cold-inferno/c5-ula-replacement/hardware/eagle-xml/ULA_Replacement.brd

## EAGLE design hardware/eagle-xml/ULA_Replacement.brd (2026-11-09)

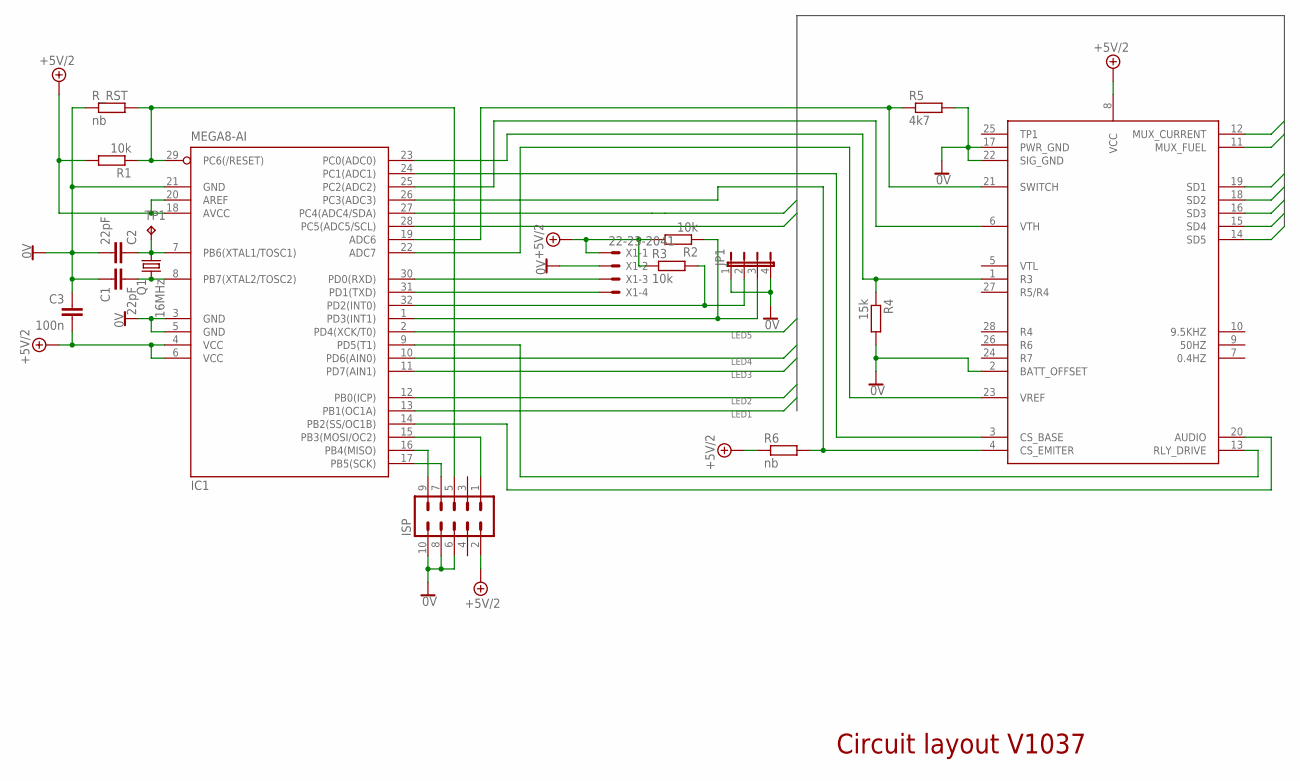
[picture p5: schematic ULA_Replacement.sch]

Parts:
C1, C2: 22pF; C0805
C3: 100n; C0805
IC1: MEGA8-AI; TQFP32-08
ISP: ML10
JP1: JP4E; JP4
Q1: 16MHz; HC49/S
R1, R2, R3: 10k; M0805
R4: 15k; M0805
R5: 4k7; M0805
R6: nb; M0805
R_RST: nb; 0204V
TP1: TPB1,27; B1,27
U$1: C5_ULA
X1: 22-23-2041

Connections:
+5V/2: C3.2, IC1.4 (VCC), IC1.6 (VCC), IC1.18 (AVCC), IC1.20 (AREF), ISP.2, R1.2, R2.2, R3.1, R6.1, U$1.8 (VCC), X1.1
/RESET: IC1.29 (PC6(/RESET)), ISP.5, R1.1, R_RST.2
AUDIO: IC1.14 (PB2(SS/OC1B)), U$1.20 (AUDIO)
CS_BASE: IC1.24 (PC1(ADC1)), U$1.3 (CS_BASE)
CS_EMITER: IC1.26 (PC3(ADC3)), R6.2, U$1.4 (CS_EMITER)
GND: C1.1, C2.2, C3.1, IC1.3 (GND), IC1.5 (GND), IC1.21 (GND), ISP.6, ISP.8, ISP.10, JP1.1, JP1.4, R4.2, R5.2, R_RST.1, U$1.2 (BATT_OFFSET), U$1.17 (PWR_GND), U$1.22 (SIG_GND), X1.2
INT0: IC1.32 (PD2(INT0)), JP1.2, R3.2
INT1: IC1.1 (PD3(INT1)), JP1.3, R2.1
LED1: IC1.13 (PB1(OC1A)), U$1.19 (SD1)
LED2: IC1.12 (PB0(ICP)), U$1.18 (SD2)
LED3: IC1.11 (PD7(AIN1)), U$1.16 (SD3)
LED4: IC1.10 (PD6(AIN0)), U$1.15 (SD4)
LED5: IC1.2 (PD4(XCK/T0)), U$1.14 (SD5)
MISO: IC1.16 (PB4(MISO)), ISP.9
MOSI: IC1.15 (PB3(MOSI/OC2)), ISP.1
MX_CURRENT: IC1.28 (PC5(ADC5/SCL)), U$1.12 (MUX_CURRENT)
MX_FUEL: IC1.27 (PC4(ADC4/SDA)), U$1.11 (MUX_FUEL)
R3: IC1.23 (PC0(ADC0)), R4.1, U$1.1 (R3)
RLY_DRIVE: IC1.9 (PD5(T1)), U$1.13 (RLY_DRIVE)
RXD: IC1.30 (PD0(RXD)), X1.3
SCK: IC1.17 (PB5(SCK)), ISP.7
SWITCH: IC1.19 (ADC6), R5.1, U$1.21 (SWITCH)
TXD: IC1.31 (PD1(TXD)), X1.4
VREF: IC1.22 (ADC7), U$1.23 (VREF)
VTH: IC1.25 (PC2(ADC2)), U$1.6 (VTH)
XTAL1: C2.1, IC1.7 (PB6(XTAL1/TOSC1)), Q1.1, TP1.TP
XTAL2: C1.2, IC1.8 (PB7(XTAL2/TOSC2)), Q1.2

Notes on the sheet:
Circuit layout V1037

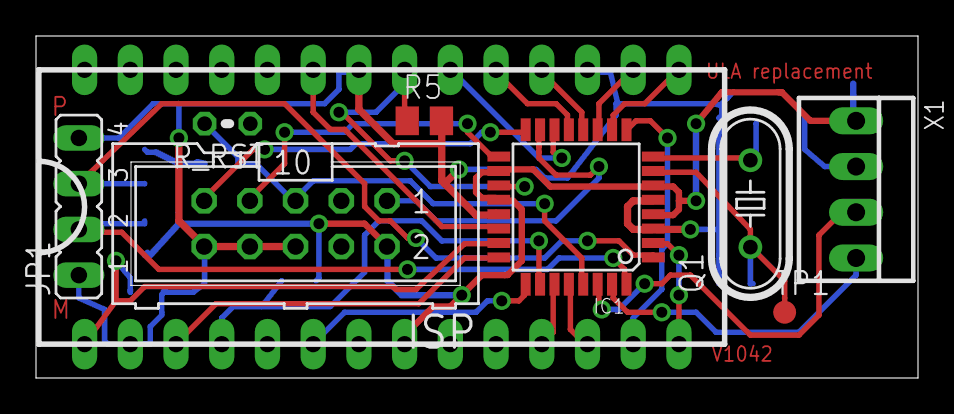
[picture p6: board ULA_Replacement.brd from above]

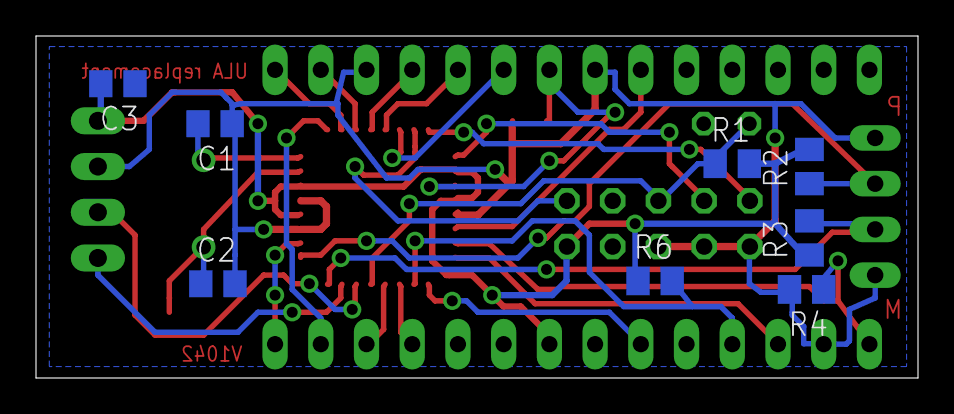
[picture p7: board ULA_Replacement.brd from below]

Board: 2 copper layers, 49.0 x 19.0 mm, 17 parts (8 on the bottom side), 27 nets.
