cold-inferno/c5-ula-replacement/global.h

#define _GLOBAL_H
#define EXTERN extern
#define WHEEL_SIZE                 1280U
#define SPEEDLIMIT_MAX              250U
#define SPEEDLIMIT_MIN               30U
#define DEFAULT_MAGNET_NUMBER_TACHO   1U
#define DEFAULT_MAGNET_NUMBER_PEDAL   1U
#if !defined(BATTERY_LIFEPO4) && !defined(BATTERY_LEAD_ACID)
#define BATTERY_LIFEPO4
#endif
#define VOLT_ADC(mV)    ((UINT16)(((UINT32)(mV) * 48UL) / 1000UL - 32UL))
#if defined(BATTERY_LIFEPO4)
  #define BATTERY_NAME          "LiFePO4"
  #define VOLT_LED1             VOLT_ADC(12500U)
  #define VOLT_LED2             VOLT_ADC(12900U)
  #define VOLT_LED3             VOLT_ADC(13050U)
  #define VOLT_LED4             VOLT_ADC(13150U)
  #define VOLT_LED5             VOLT_ADC(13300U)
  #define VOLT_WARN_ON          VOLT_ADC(12800U)
  #define VOLT_WARN_OFF         VOLT_ADC(12900U)
  #define VOLT_ERR_ON           VOLT_ADC(12000U)
  #define VOLT_ERR_OFF          VOLT_ADC(12300U)
  #define VOLT_ERR_LOADED       VOLT_ADC(11000U)
  #define VOLT_REST_SETTLE      6U
#else
  #define BATTERY_NAME          "lead-acid"
  #define VOLT_LED1             VOLT_ADC(10000U)
  #define VOLT_LED2             VOLT_ADC(10500U)
  #define VOLT_LED3             VOLT_ADC(11000U)
  #define VOLT_LED4             VOLT_ADC(11500U)
  #define VOLT_LED5             VOLT_ADC(12000U)
  #define VOLT_REST_SETTLE      6U
#endif
#define RXD_PORT            PORTD
#define RXD_DDR             DDRD
#define RXD_BIT             PD0
#define TXD_PORT            PORTD
#define TXD_DDR             DDRD
#define TXD_BIT             PD1
#define LED1_PORT           PORTB
#define LED1_DDR            DDRB
#define LED1_BIT            PB1
#define LED2_PORT           PORTB
#define LED2_DDR            DDRB
#define LED2_BIT            PB0
#define LED3_PORT           PORTD
#define LED3_DDR            DDRD
#define LED3_BIT            PD7
#define LED4_PORT           PORTD
#define LED4_DDR            DDRD
#define LED4_BIT            PD6
#define LED5_PORT           PORTD
#define LED5_DDR            DDRD
#define LED5_BIT            PD4
#define MUX_VOLT_PORT       PORTC
#define MUX_VOLT_DDR        DDRC
#define MUX_VOLT_BIT        PC4
#define MUX_CURR_PORT       PORTC
#define MUX_CURR_DDR        DDRC
#define MUX_CURR_BIT        PC5
#define SPEAKER_PORT        PORTB
#define SPEAKER_DDR         DDRB
#define SPEAKER_BIT         PB2
#define RELAY_PORT          PORTD
#define RELAY_DDR           DDRD
#define RELAY_BIT           PD5
#define FAN_PORT            PORTC
#define FAN_DDR             DDRC
#define FAN_BIT             PC3
#define INT0_PORT           PORTD
#define INT0_DDR            DDRD
#define INT0_BIT            PD2
#define INT1_PORT           PORTD
#define INT1_DDR            DDRD
#define INT1_BIT            PD3
#define VREF_PORT           PORTC
#define VREF_DDR            DDRC
#define VREF_BIT            7
#define CSBASE_PORT         PORTC
#define CSBASE_DDR          DDRC
#define CSBASE_BIT          PC1
#define R3_PORT             PORTC
#define R3_DDR              DDRC
#define R3_BIT              PC0
#define VTH_PORT            PORTC
#define VTH_DDR             DDRC
#define VTH_BIT             PC2
#define SWITCH_PORT         PORTC
#define SWITCH_DDR          DDRC
#define SWITCH_BIT          6
#define ADC_SWITCH          ADC6
#define ADC_TEMPERATURE     ADC2
#define ADC_VOLTAGE         ADC0
#define ADC_VREF            ADC7
#define ADC_CURRENT         ADC1
#define SWITCH_ON_ADC       300U
#define MAX_CURRENT         523U
#define VALUE_TEMP_FAN        45U // 45°C
#define VALUE_TEMP_WARN       70U // 70°C
#define VALUE_TEMP_ERROR      80U // 80°C
#define ONE_MINUTE_MS       ((UINT32)60000UL)
#define FW_VERSION          1203U  // 2026: V1200 LiFePO4 + pedelec, V1201 speed bar, V1202 ride log, V1203 fault codes + resting voltage fix
#define APPLICATION_CRC     0xFFFFFFFFUL // patched after build by tools/fwcrc.py
#define CRC32POLY           0xEDB88320UL
#define STATIC              static
#define LOCAL_STATIC        static
#define CONST               const
#define VOLATILE            volatile
#define SECTION_EEMEM       __attribute__ ((section (".eeprom")))
#define SECTION_VERSION     __attribute__ ((section (".app_ver")))
#define SECTION_CRC         __attribute__ ((section (".app_crc")))
#define HIGH_BYTE(x) ((UINT8) (x >> 8U))
#define LOW_BYTE(x)  ((UINT8)  x)
#define LED1_ON()       LED1_PORT &= ~(1U << LED1_BIT);
#define LED1_OFF()      LED1_PORT |=  (1U << LED1_BIT);
#define LED2_ON()       LED2_PORT &= ~(1U << LED2_BIT);
#define LED2_OFF()      LED2_PORT |=  (1U << LED2_BIT);
#define LED3_ON()       LED3_PORT &= ~(1U << LED3_BIT);
#define LED3_OFF()      LED3_PORT |=  (1U << LED3_BIT);
#define LED4_ON()       LED4_PORT &= ~(1U << LED4_BIT);
#define LED4_OFF()      LED4_PORT |=  (1U << LED4_BIT);
#define LED5_ON()       LED5_PORT &= ~(1U << LED5_BIT);
#define LED5_OFF()      LED5_PORT |=  (1U << LED5_BIT);
#define ALL_LEDS_ON()   {LED1_ON(); LED2_ON(); LED3_ON(); \
                         LED4_ON(); LED5_ON();}
#define ALL_LEDS_OFF()  {LED1_OFF(); LED2_OFF(); LED3_OFF(); \
                         LED4_OFF();LED5_OFF();}
#define MUX_CURR()      { MUX_CURR_PORT |=  (1U << MUX_CURR_BIT); \
                          MUX_VOLT_PORT &= ~(1U << MUX_VOLT_BIT); }
#define MUX_VOLT()      { MUX_VOLT_PORT |=  (1U << MUX_VOLT_BIT); \
                          MUX_CURR_PORT &= ~(1U << MUX_CURR_BIT); }
#ifndef BOOTLOADER
EXTERN const UINT32           g_u32ApplicationCRC;
EXTERN const UINT16           g_u16ApplicationVersion;
#endif
EXTERN const S_MEM_STRUCTRUE  sMemoryEEPROM;
#undef EXTERN
