cold-inferno/c5-ula-replacement/(commit log)

2026-11-06 Import cypax ULA replacement firmware V1172 (CRLF normalised)
    [adc.c, adc.h, bootload.c, bootload.h, current.c, current.h, fan.c, fan.h]
2026-11-06 Firmware V1200: LiFePO4 profile, pedelec fixes, browser configurator
    Firmware (builds with avr-gcc 14, 5488 of 7162 bytes):
    - Port to modern avr-libc (ISR vector names, chip detection, avr-size)
    - Replace printf/fdevopen with small print functions (~1.4 KB freed)
    - Speed uses the configured wheel size (was fixed 1280 mm)
    - Pedelec relay decision moved to pedelec.c: hysteresis at both speed
    limits, 500 ms minimum relay dwell, safety cut-offs stay immediate
    - Max speed 0 disables the upper speed cut-off
    - Pedal sensor debounce, magnet count 0 guard, no phantom pedalling
    after power-on
    - LiFePO4 battery profile (default): LED bar and cut-off on resting
    voltage, low-battery warning, loaded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
    [global.h, leds.c, pedal.c, pedal.h, pedelec.c, pedelec.h, print.c]
2026-11-06 Firmware V1201: speed on the pod's left LED bar
    - Left bar shows speed (1 LED per 5 km/h, top LED flashing above
    30 km/h) while the motor button is released, motor current while it
    is pressed; warnings/errors keep priority
    - Main loop passes button state and speed level to the LED ISR every
    128 ms (no ADC or sensor reads inside the ISR)
    - Motor button now counts as pressed above ADC 300 (was any value > 0)
    - pedelec_SpeedBarLevel() with 9 new host tests (36 checks total)
    - Configurator: Pod LEDs tile mirroring both bars; demo presses the
    button independently of the relay
    - release/: V1201 firmware, EEPROM defaults renamed without version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
    [global.h, leds.c, leds.h, pedelec.c, pedelec.h, switch.c, test_pedelec.c, ula_repl.c]
2026-11-08 ATmega328P support, bootloader V1043, build and serial tools
    Firmware and bootloader now build for both pin-compatible chips:
    make MCU=atmega88 (original design)
    make MCU=atmega328p (e.g. replacement chips)
    The application layout (version/CRC at the end of the first 7 KB) is
    the same on both, so the upload protocol, configurator and CRC tool are
    unchanged. The 328P bootloader lives at 0x7800 (hfuse BOOTSZ=01).
    Bootloader V1043 (protocol unchanged):
    - collects 64-byte protocol blocks into 128-byte flash pages on the
    328P; the original wrote SPM_PAGESIZE bytes from a 64-byte buffer
    - disables the watchdog at start; after a watchdog reset it kept
    resetting every ~16 ms and never star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
    [bootload.c]
2026-11-08 Firmware V1202: optional ride log; bootloader V1044
    Ride log (ridelog.c, off by default, setting byte 11 = 1 switches it on;
    nothing is written to the EEPROM while it is off):
    - reset-cause counters (power-on, brown-out, watchdog, external reset)
    - event log of warnings/errors and a thermistor reading of ~0, with
    speed/voltage/current/temperature; max one per type per 30 s and 40
    per ride; ring buffer of 85 (328P) / 21 (ATmega88) events
    - black box: last 60 s at 1 sample/s kept in .noinit RAM, copied to the
    EEPROM after an unexpected restart (watchdog, brown-out, reset)
    Bootloader V1044 hands the reset cause to the firmware in GPIOR0.
    Build: -flto, -ffunction-sections/--gc-sections a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
    [bootload.c, global.c, global.h, ridelog.c, ridelog.h, ula_repl.c]
2026-11-09 Add README, LICENSE and hardware files for publishing
    - README.md: what the project is, changes against cypax V1172, layout,
    hardware and C5 modifications, fuses and flashing, configurator,
    EEPROM settings, serial format, building and tools, credits
    - LICENSE.md: original licenses kept (code/hardware CC BY-NC-SA 3.0,
    documentation CC BY-SA 3.0) with attribution to Philipp Bank (cypax)
    - hardware/: cypax's original Eagle files, EAGLE XML export, KiCad
    project (verified against the Eagle board: all parts, tracks, vias
    identical) and the Gerber/drill/placement zip, plus a preview render
    [ULA_Replacement.brd, ULA_Replacement.sch, ULA_Replacement_4Kicad.kicad_pcb, ULA_Replacement_4Kicad.kicad_sch]
2026-11-13 V1203: clear fault codes, resting-voltage fix, stall protection, chip check
    Firmware
    - Resting battery voltage is measured whenever the motor can't draw current
    (button released or relay off). It froze at its power-on value without
    pedal assist, so the charge bar, low-battery warning and cut-off never
    updated.
    - Fault codes on the left bar: LED1 battery, LED3 current, LED5 temperature;
    slow flash = warning, fast flash = error; buzzer in the same rhythm. The
    old code mixed the fault LEDs with the battery bar pattern.
    - Stall protection: about 80 A for 3 s without a wheel pulse, or the third
    140 A cut in a row, cuts the motor until the button is released.
    - Temperature table: 65 an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
    [current.c, global.h, leds.c, leds.h, pedelec.c, pedelec.h, ridelog.c, temp.c]
